ktoniman/Solar-Tracker/README.md

Electrical Engineering Principles and Practices (E1111A) Project
a Y1S1 project to be improved

If time allows, next pcb iteration using copper pours
