ktoniman/Solar-Tracker/Datasheets and BOM/BOM from JLCPCB Assembly.xlsx

Parts Type | JLCPCB Part # | MFR Part # | Description | Unit Price | Qty | Total Price
stock | C36417 | SWPA8040S4R7NT | 25mΩ 4.1A 4.7uH 6.5A ±30% SMD,8x8mm Power Inductors ROHS | 0.1298 | 2 | 0.26
stock | C84817 | MT3608 | -40℃~+85℃ 1 1.2MHz 100uA、1.6mA 2A 2V~24V Adjustable Boost Boost Built-in No SOT-23-6 DC-DC Converters ROHS | 0.0782 | 2 | 0.16
stock | C28233 | CL21B104KCFNNNE | 100V 100nF X7R ±10% 0805 Multilayer Ceramic Capacitors MLCC - SMD/SMT ROHS | 0.0095 | 8 | 0.08
stock | C45783 | CL21A226MAQNNNE | 22uF 25V X5R ±20% 0805 Multilayer Ceramic Capacitors MLCC - SMD/SMT ROHS | 0.0315 | 4 | 0.13
stock | C23242 | 0603WAF7502T5E | -55℃~+155℃ 100mW 75V 75kΩ Thick Film Resistor ±1% ±100ppm/℃ 0603 Chip Resistor - Surface Mount ROHS | 0.0012 | 2 | 0.01
stock | C17414 | 0805W8F1002T5E | -55℃~+155℃ 10kΩ 125mW 150V Thick Film Resistor ±1% ±100ppm/℃ 0805 Chip Resistor - Surface Mount ROHS | 0.0024 | 4 | 0.01
stock | C22452 | SS54 | -55℃~+125℃ 1mA@40V 40V 550mV@5A 5A Independent SMA(DO-214AC) Schottky Diodes ROHS | 0.0356 | 3 | 0.11
stock | C3342 | RVT1C221M0607 | -55℃~+105℃ 16V 2000hrs@105℃ 220uF 6.3mm 7.7mm ±20% SMD,D6.3xL7.7mm Aluminum Electrolytic Capacitors - SMD ROHS | 0.0345 | 4 | 0.14
