ktoniman/Solar-Tracker/Calculations/Boost Calculations.pdf

## Egg

T.EE | i.t | iisEoioeforsmo

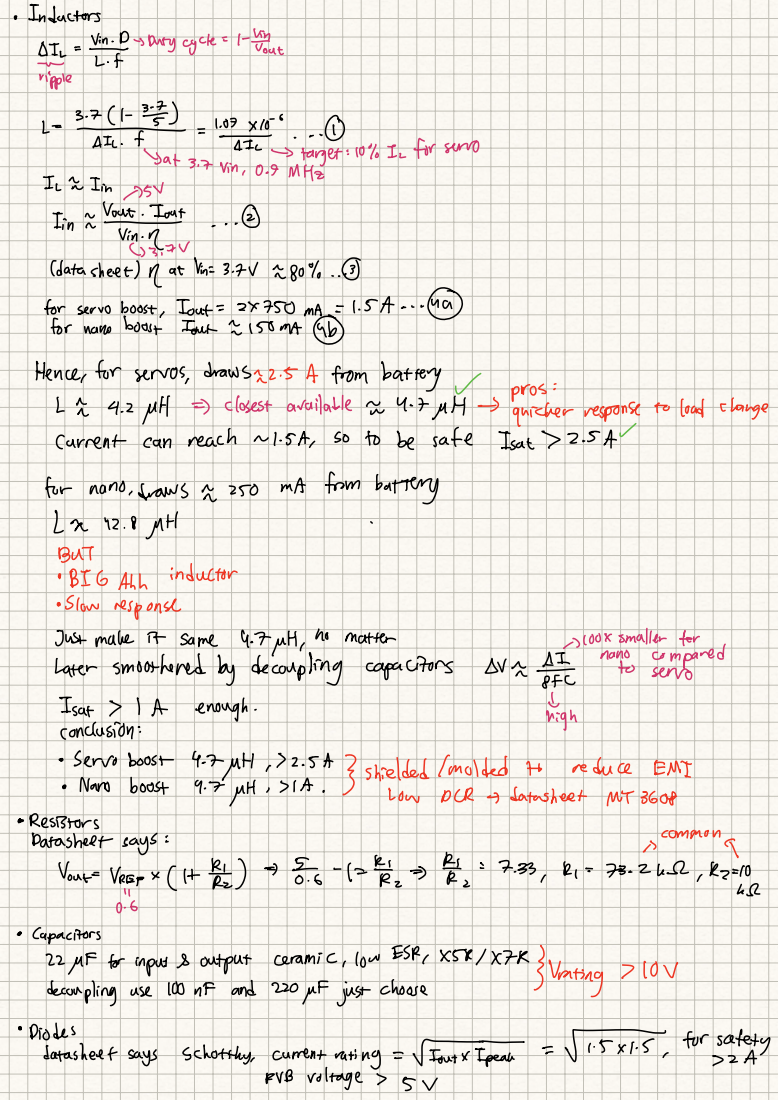
[picture p1: page 1]
Inductors; Dutycycle; 1you; IIÉvÉÉt; datasheetREVin; Eat; Hence for servos; draws22.5 A frombattery; closest available; Patherresponse to load; chang; caurent; can; reach; to be safe; Isat; for nanodraws; mA from battery; La 42.8MH But; BIGALL; inductor; Slow response; Justmake it; same; matter; Later smootheredby decoupling; capacitors; hall Infrared; enough; high conclusion; Servoboost 47MH; shielded; molded to; reduce; EMI Nano; boost; SIA; Low; PCR; datasheet; Resistors Datasheetsays Vout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
