ktoniman/Solar-Tracker/abcdefg.kicad_pcb

## KiCad design abcdefg.kicad_pcb (2026-03-31)

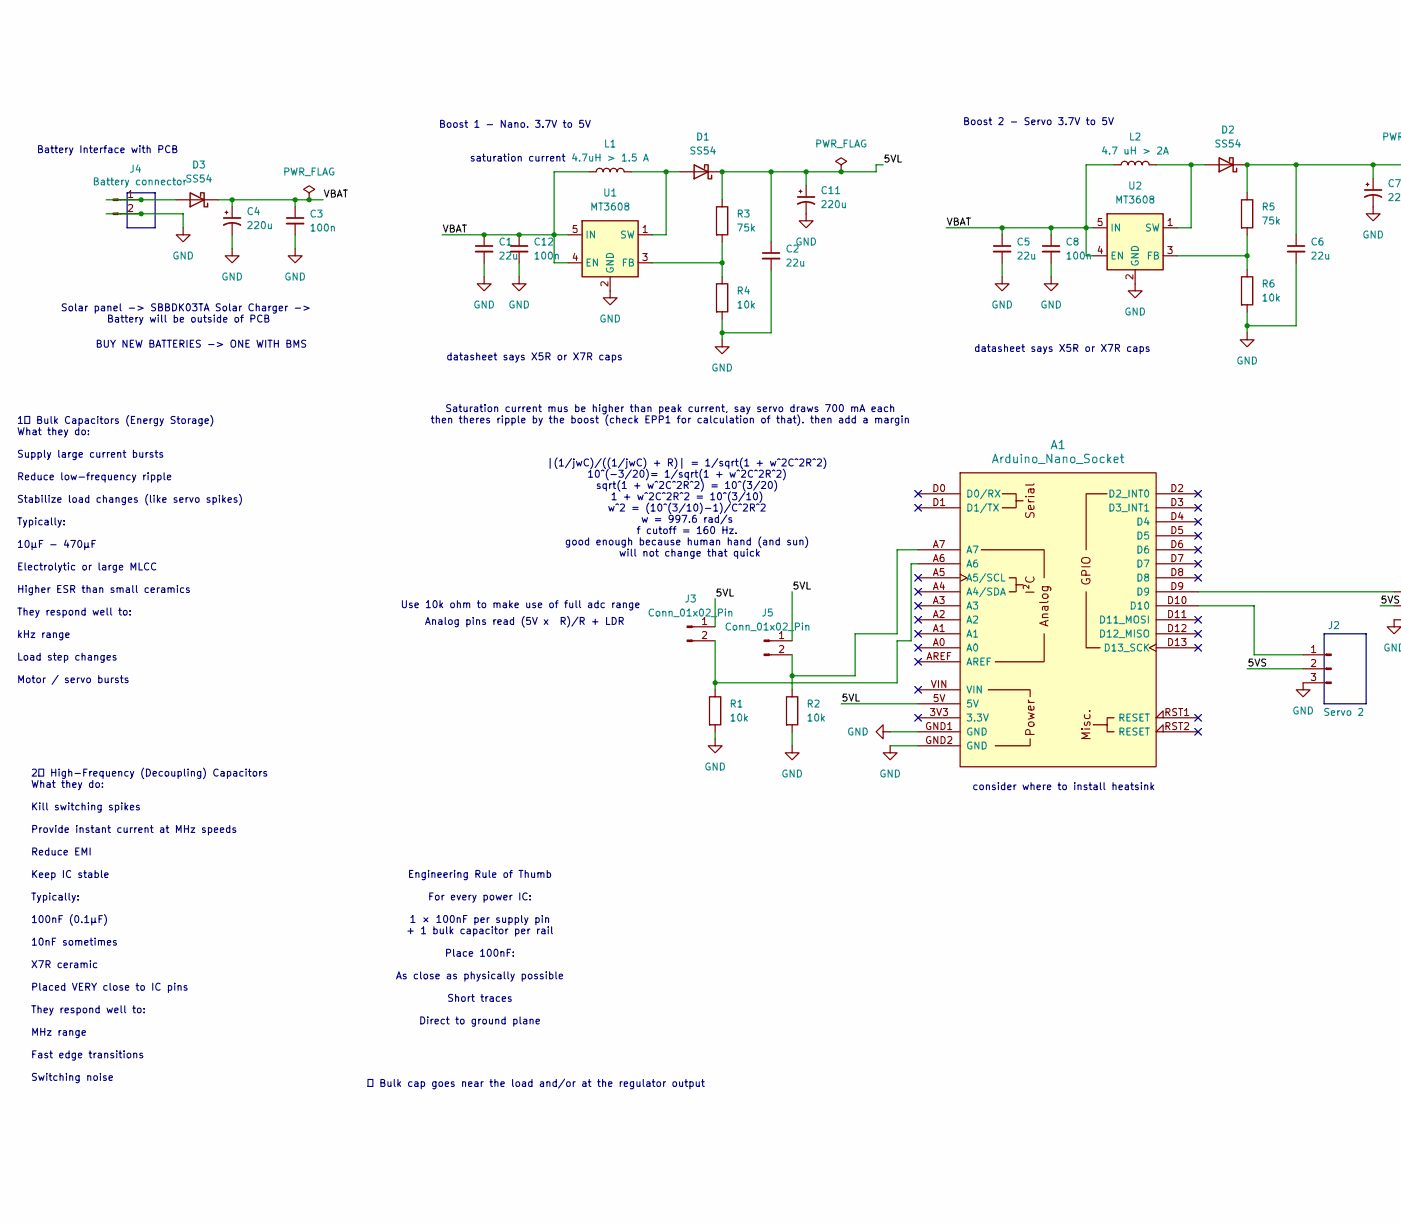
[picture p2: schematic abcdefg.kicad_sch, Solar Tracker EPP1, part in row 1, column 1]

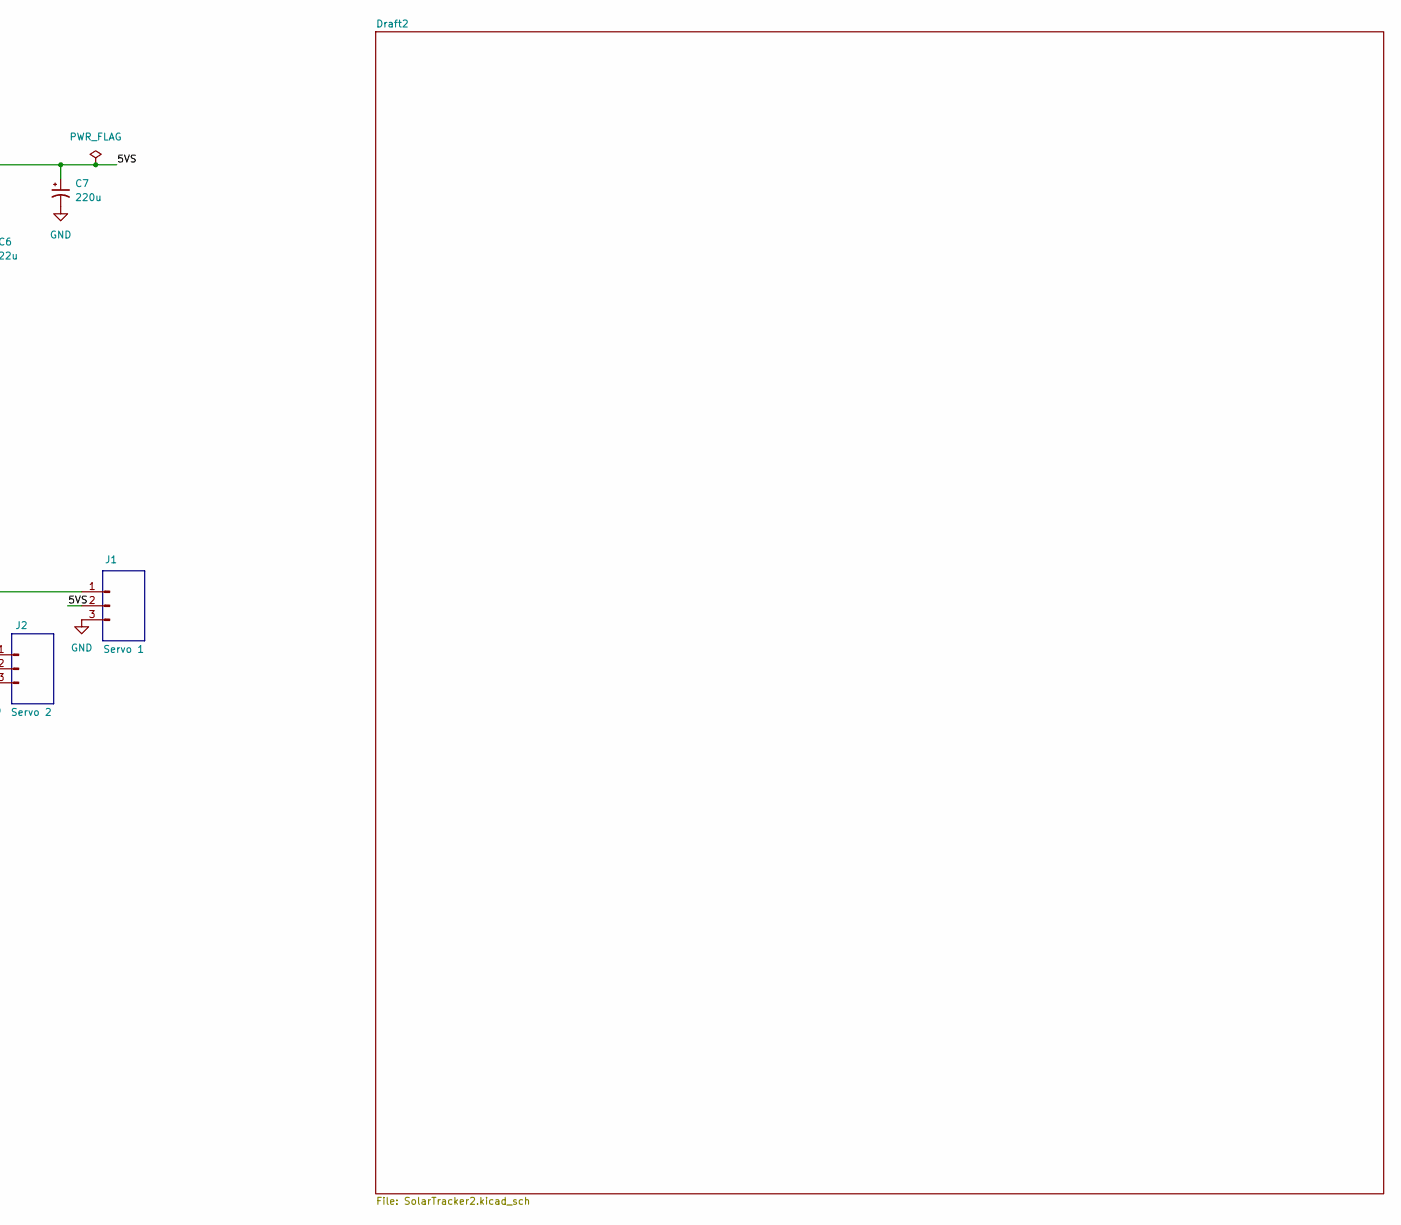
[picture p3: schematic abcdefg.kicad_sch, Solar Tracker EPP1, part in row 1, column 2]

Parts:
A1: Arduino_Nano_Socket
C1, C2, C5, C6: 22u; C_0805_2012Metric
C3, C8, C12: 100n; C_0805_2012Metric
C4, C7, C11: 220u; CP_Elec_6.3x7.7
D1, D2, D3: SS54; D_SMA
J1: Servo 1; JST_XH_B3B-XH-A_1x03_P2.50mm_Vertical
J2: Servo 2; JST_XH_B3B-XH-A_1x03_P2.50mm_Vertical
J3, J5: Conn_01x02_Pin; JST_XH_B2B-XH-A_1x02_P2.50mm_Vertical
J4: Battery connector; JST_XH_B2B-XH-A_1x02_P2.50mm_Vertical
L1: 4.7uH > 1.5 A; L_Sunlord_SWPA8040S
L2: 4.7 uH > 2A; L_Sunlord_SWPA8040S
R1, R2, R4, R6: 10k; R_0805_2012Metric
R3, R5: 75k; R_0603_1608Metric
U1, U2: MT3608; SOT-23-6

Connections:
/5VL: A1.5V, C2.1, C11.1, D1.1 (K), J3.1, J5.1, R3.1
/5VS: C6.1, C7.1, D2.1 (K), J1.2, J2.2, R5.1
/VBAT: C1.1, C3.1, C4.1, C5.1, C8.1, C12.1, D3.1 (K), L1.1, L2.1, U1.4 (EN), U1.5 (IN), U2.4 (EN), U2.5 (IN)
GND: A1.GND1 (GND), A1.GND2 (GND), C1.2, C2.2, C3.2, C4.2, C5.2, C6.2, C7.2, C8.2, C11.2, C12.2, J1.3, J2.3, J4.2, R1.2, R2.2, R4.2, R6.2, U1.2 (GND), U2.2 (GND)
unnamed: D1.2 (A), L1.2, U1.1 (SW)
unnamed: D2.2 (A), L2.2, U2.1 (SW)
unnamed: D3.2 (A), J4.1
unnamed: A1.D9, J1.1
unnamed: A1.D10, J2.1
unnamed: A1.A6, J3.2, R1.1
unnamed: A1.A7, J5.2, R2.1
unnamed: R3.2, R4.1, U1.3 (FB)
unnamed: R5.2, R6.1, U2.3 (FB)

Notes on the sheet:
BUY NEW BATTERIES -> ONE WITH BMS
Solar panel -> SBBDK03TA Solar Charger -> Battery will be outside of PCB
Battery Interface with PCB
2️⃣ High-Frequency (Decoupling) Capacitors What they do: Kill switching spikes Provide instant current at MHz speeds Reduce EMI Keep IC stable Typically: 100nF (0.1µF) 10nF sometimes X7R ceramic Placed VERY close to IC pins They respond well to: MHz range Fast edge transitions Switching noise
1️⃣ Bulk Capacitors (Energy Storage) What they do: Supply large current bursts Reduce low-frequency ripple Stabilize load changes (like servo spikes) Typically: 10µF - 470µF Electrolytic or large MLCC Higher ESR than small ceramics They respond well to: kHz range Load step changes Motor / servo bur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
Use 10k ohm to make use of full adc range
Boost 2 - Servo 3.7V to 5V
datasheet says X5R or X7R caps
Saturation current mus be higher than peak current, say servo draws 700 mA each then theres ripple by the boost (check EPP1 for calculation of that). then add a margin
Analog pins read (5V x R)/R + LDR
saturation current
|(1/jwC)/((1/jwC) + R)| = 1/sqrt(1 + w^2C^2R^2) 10^(-3/20)= 1/sqrt(1 + w^2C^2R^2) sqrt(1 + w^2C^2R^2) = 10^(3/20) 1 + w^2C^2R^2 = 10^(3/10) w^2 = (10^(3/10)-1)/C^2R^2 w = 997.6 rad/s f cutoff = 160 Hz. good enough because human hand (and sun) will not change that quick
Engineering Rule of Thumb For every power IC: 1 × 100nF per supply pin + 1 bulk capacitor per rail Place 100nF: As close as physically possible Short traces Direct to ground plane
consider where to install heatsink
✅ Bulk cap goes near the load and/or at the regulator output
Boost 1 - Nano. 3.7V to 5V

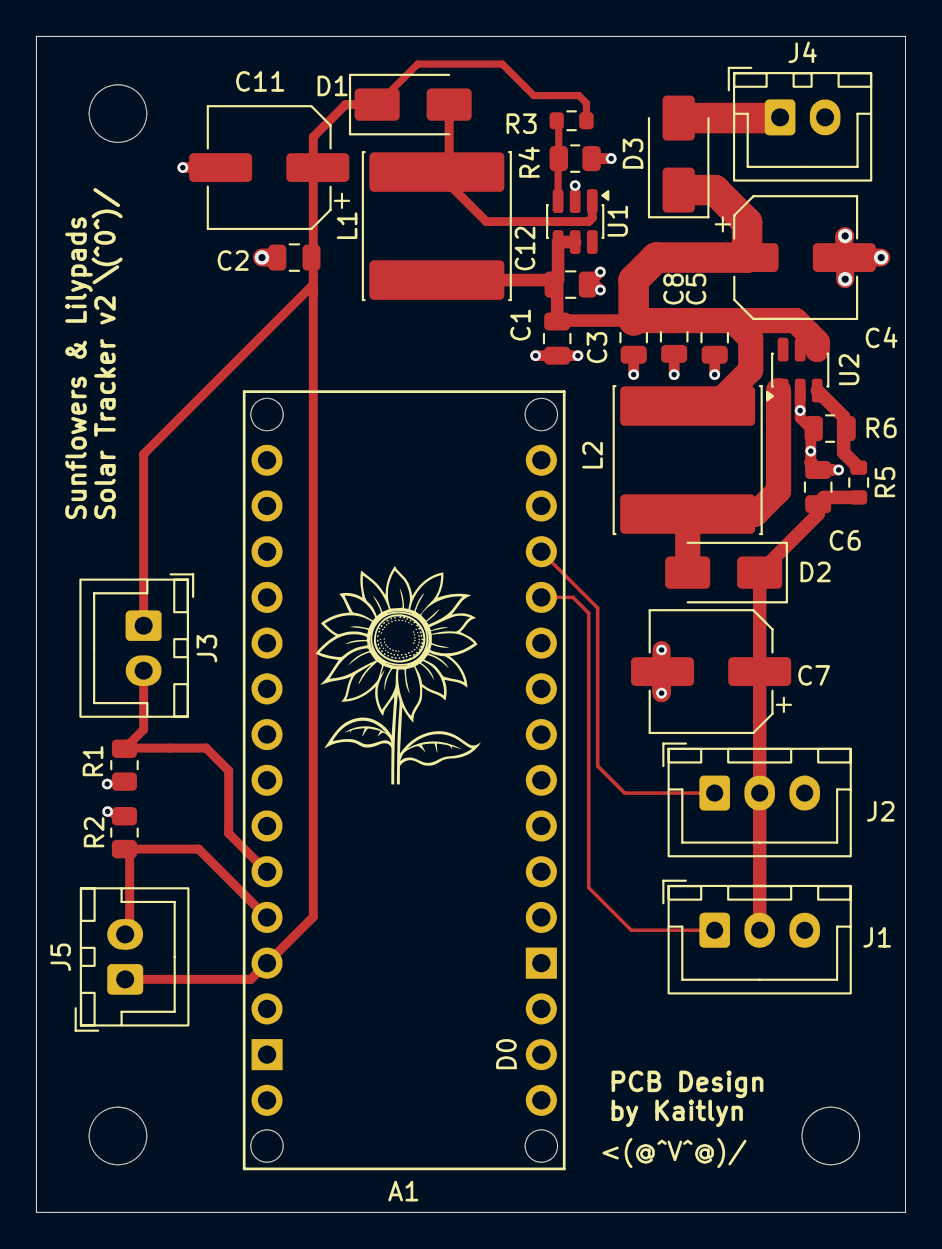
[picture p4: board abcdefg.kicad_pcb from above]

Board: 2 copper layers, 48.3 x 65.3 mm, 29 parts (0 on the bottom side), 13 nets.
