ktoniman/Solar-Tracker/(commit log)

2026-03-27 Put into files
    [abcdefg-B_Cu.gbl, abcdefg-B_Cu.gbr, abcdefg-B_Mask.gbr, abcdefg-B_Mask.gbs, abcdefg-B_Paste.gbp, abcdefg-B_Paste.gbr, abcdefg-B_Silkscreen.gbo, abcdefg-B_Silkscreen.gbr]
2026-03-30 Updated PCB layout
    [SolarTracker2.kicad_sch, abcdefg.kicad_pcb, abcdefg.kicad_sch]
2026-03-30 code uploaded
    [SolarTracker2.kicad_sch]
2026-03-30 BOM uploaded
    [BOM from JLCPCB Assembly.xlsx]
2026-03-31 Traces made bigger, c2 moved, changed connectors
    [JLCPCB.kicad_pcb, JLCPCB.kicad_sch, SolarTracker2.kicad_sch, abcdefg.kicad_pcb, abcdefg.kicad_pcb_saigooner.kicad_pcb, abcdefg.kicad_sch, bom.csv, designators.csv]
